RossDuquette/FYDP-Elec-Design/slave_board.brd

## EAGLE design slave_board.brd (2019-01-23)

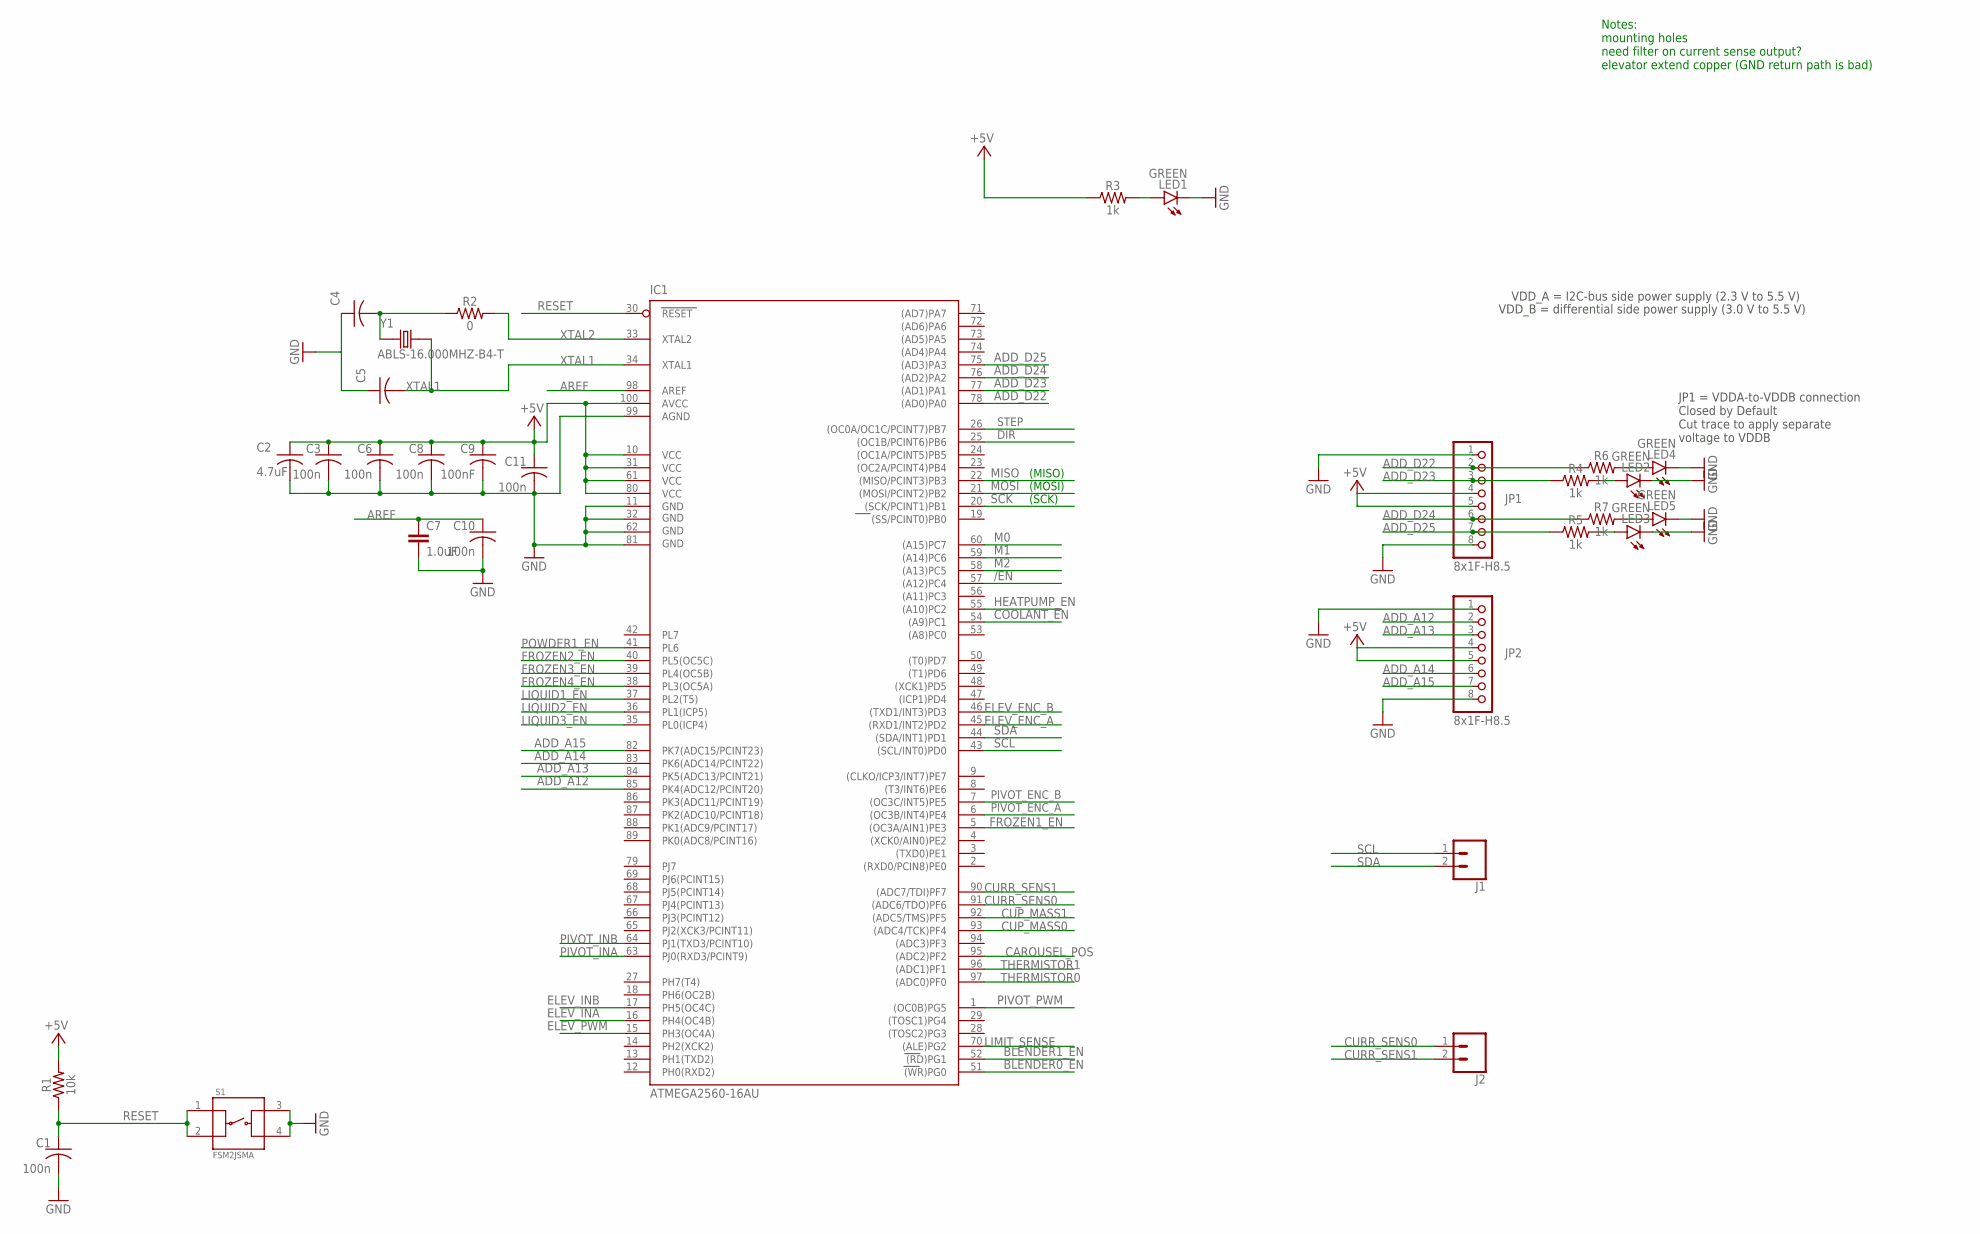
[picture p7: schematic slave_board.sch, sheet 1, Main]

Parts:
C1, C3, C6, C8, C10, C11: 100n; C0603
C2: 4.7uF; C0603
C4, C5: 15pF; C0603
C7: 1.0uF; 0603
C9: 100nF; C0603
IC1: ATMEGA2560-16AU; TQFP100
J1, J2: CONN_02; 1X02
JP1, JP2: 8x1F-H8.5; 1X08
LED1, LED2, LED3, LED4, LED5: GREEN; CHIP-LED0805
R1: 10k; 0603
R2: 0; 0603
R3, R4, R5, R6, R7: 1k; 0603
S1: FSM2JSMA
Y1: ABLS-16.000MHZ-B4-T

Connections:
+5V: C2.1, C3.1, C6.1, C8.1, C9.1, C11.1, IC1.10 (VCC), IC1.31 (VCC1), IC1.61 (VCC2), IC1.80 (VCC3), IC1.100 (AVCC), JP1.4, JP1.5, JP2.4, JP2.5, R1.2, R3.1; also elsewhere on the board
/EN: IC1.57 ((A12)PC4); also elsewhere on the board
ADD_A12: IC1.85 (PK4(ADC12/PCINT20)), JP2.2
ADD_A13: IC1.84 (PK5(ADC13/PCINT21)), JP2.3
ADD_A14: IC1.83 (PK6(ADC14/PCINT22)), JP2.6
ADD_A15: IC1.82 (PK7(ADC15/PCINT23)), JP2.7
ADD_D22: IC1.78 ((AD0)PA0), JP1.2, R6.1
ADD_D23: IC1.77 ((AD1)PA1), JP1.3, R4.1
ADD_D24: IC1.76 ((AD2)PA2), JP1.6, R7.1
ADD_D25: IC1.75 ((AD3)PA3), JP1.7, R5.1
AREF: C7.1, C10.1, IC1.98 (AREF)
BLENDER0_EN: IC1.51 ((WR)PG0); also elsewhere on the board
BLENDER1_EN: IC1.52 ((RD)PG1); also elsewhere on the board
CAROUSEL_POS: IC1.95 ((ADC2)PF2); also elsewhere on the board
COOLANT_EN: IC1.54 ((A9)PC1); also elsewhere on the board
CUP_MASS0: IC1.93 ((ADC4/TCK)PF4); also elsewhere on the board
CUP_MASS1: IC1.92 ((ADC5/TMS)PF5); also elsewhere on the board
CURR_SENS0: IC1.91 ((ADC6/TDO)PF6), J2.1; also elsewhere on the board
CURR_SENS1: IC1.90 ((ADC7/TDI)PF7), J2.2; also elsewhere on the board
DIR: IC1.25 ((OC1B/PCINT6)PB6); also elsewhere on the board
ELEV_ENC_A: IC1.45 ((RXD1/INT2)PD2); also elsewhere on the board
ELEV_ENC_B: IC1.46 ((TXD1/INT3)PD3); also elsewhere on the board
ELEV_INA: IC1.16 (PH4(OC4B)); also elsewhere on the board
ELEV_INB: IC1.17 (PH5(OC4C)); also elsewhere on the board
ELEV_PWM: IC1.15 (PH3(OC4A)); also elsewhere on the board
FROZEN1_EN: IC1.5 ((OC3A/AIN1)PE3); also elsewhere on the board
FROZEN2_EN: IC1.40 (PL5(OC5C)); also elsewhere on the board
FROZEN3_EN: IC1.39 (PL4(OC5B)); also elsewhere on the board
FROZEN4_EN: IC1.38 (PL3(OC5A)); also elsewhere on the board
GND: C1.2, C2.2, C3.2, C4.1, C5.1, C6.2, C7.2, C8.2, C9.2, C10.2, C11.2, IC1.11 (GND), IC1.32 (GND1), IC1.62 (GND2), IC1.81 (GND3), IC1.99 (AGND), JP1.1, JP1.8, JP2.1, JP2.8, LED1.C, LED2.C, LED3.C, LED4.C, LED5.C, S1.3, S1.4; also elsewhere on the board
HEATPUMP_EN: IC1.55 ((A10)PC2); also elsewhere on the board
LIMIT_SENSE: IC1.70 ((ALE)PG2); also elsewhere on the board
LIQUID1_EN: IC1.37 (PL2(T5)); also elsewhere on the board
LIQUID2_EN: IC1.36 (PL1(ICP5)); also elsewhere on the board
LIQUID3_EN: IC1.35 (PL0(ICP4)); also elsewhere on the board
M0: IC1.60 ((A15)PC7); also elsewhere on the board
M1: IC1.59 ((A14)PC6); also elsewhere on the board
M2: IC1.58 ((A13)PC5); also elsewhere on the board
MISO: IC1.22 ((MISO/PCINT3)PB3); also elsewhere on the board
MOSI: IC1.21 ((MOSI/PCINT2)PB2); also elsewhere on the board
unnamed: LED5.A, R7.2
unnamed: LED1.A, R3.2
unnamed: LED3.A, R5.2
unnamed: LED4.A, R6.2
unnamed: LED2.A, R4.2
unnamed: C4.2, R2.1, Y1.1
PIVOT_ENC_A: IC1.6 ((OC3B/INT4)PE4); also elsewhere on the board
PIVOT_ENC_B: IC1.7 ((OC3C/INT5)PE5); also elsewhere on the board
PIVOT_INA: IC1.63 (PJ0(RXD3/PCINT9)); also elsewhere on the board
PIVOT_INB: IC1.64 (PJ1(TXD3/PCINT10)); also elsewhere on the board
PIVOT_PWM: IC1.1 ((OC0B)PG5); also elsewhere on the board
POWDER1_EN: IC1.41 (PL6); also elsewhere on the board
RESET: C1.1, IC1.30 (RESET), R1.1, S1.1, S1.2; also elsewhere on the board
SCK: IC1.20 ((SCK/PCINT1)PB1); also elsewhere on the board
SCL: IC1.43 ((SCL/INT0)PD0), J1.1; also elsewhere on the board
SDA: IC1.44 ((SDA/INT1)PD1), J1.2; also elsewhere on the board
STEP: IC1.26 ((OC0A/OC1C/PCINT7)PB7); also elsewhere on the board
THERMISTOR0: IC1.97 ((ADC0)PF0); also elsewhere on the board
THERMISTOR1: IC1.96 ((ADC1)PF1); also elsewhere on the board
XTAL1: C5.2, IC1.34 (XTAL1), Y1.2
XTAL2: IC1.33 (XTAL2), R2.2

Notes on the sheet:
Notes: mounting holes need filter on current sense output? elevator extend copper (GND return path is bad)
JP1 = VDDA-to-VDDB connection Closed by Default Cut trace to apply separate voltage to VDDB
VDD_A = I2C-bus side power supply (2.3 V to 5.5 V)
VDD_B = differential side power supply (3.0 V to 5.5 V)
(MISO)
(SCK)
(MOSI)

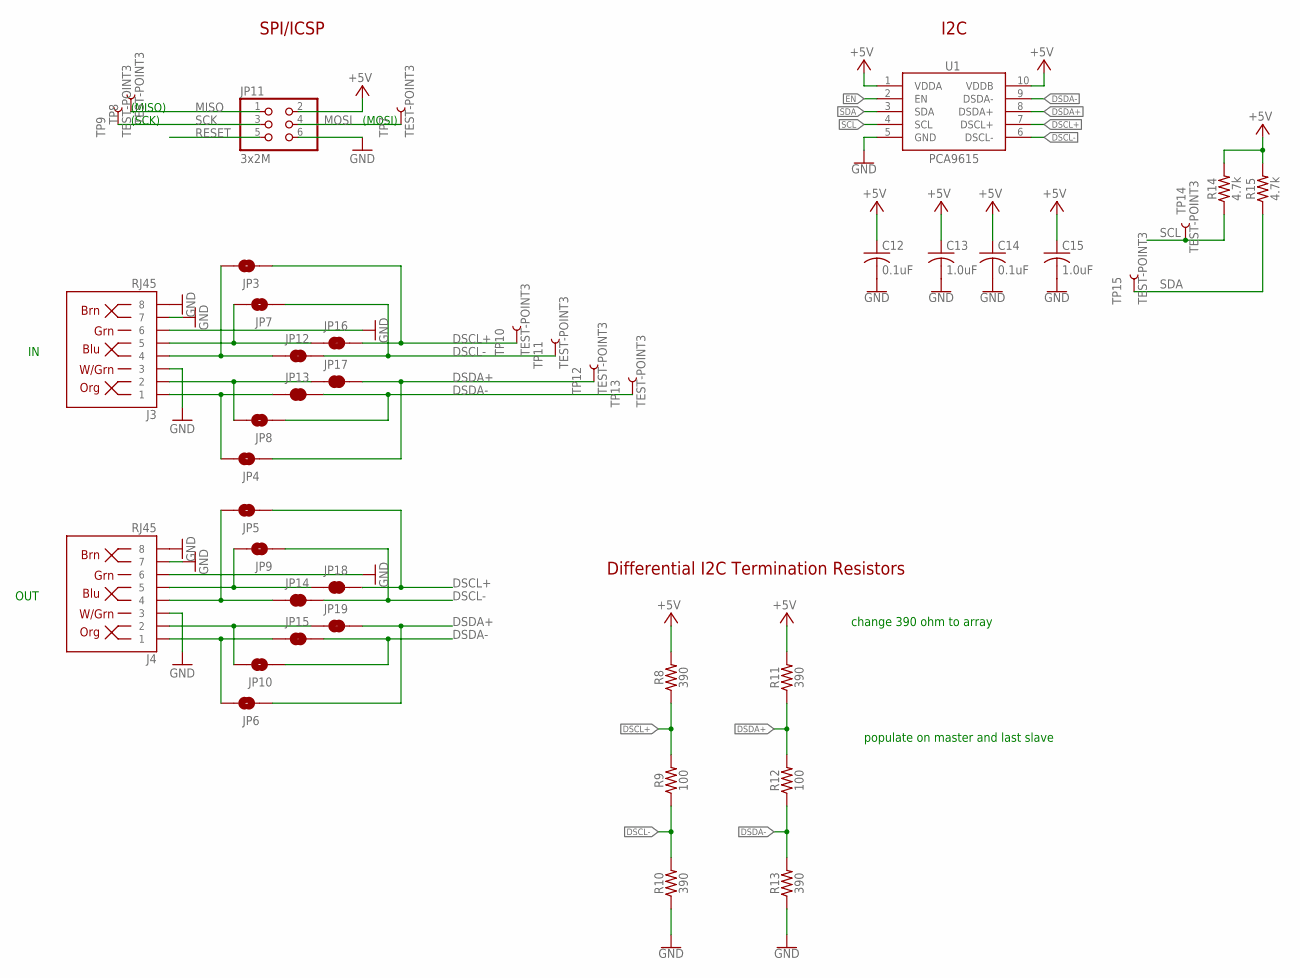
[picture p8: schematic slave_board.sch, sheet 2, COMMS]

Parts:
C12, C14: 0.1uF; C0603
C13, C15: 1.0uF; C0603
J3, J4: RJ45; RJ45-8
JP3, JP4, JP5, JP6, JP7, JP8, JP9, JP10: JUMPER-SMT_2_NO_NO-SILK; SMT-JUMPER_2_NO_NO-SILK
JP11: 3x2M; 2X03
JP12, JP13, JP14, JP15, JP16, JP17, JP18, JP19: JUMPER-SMT_2_NC_TRACE_NO-SILK; SMT-JUMPER_2_NC_TRACE_NO-SILK
R8, R10, R11, R13: 390; 0603
R9, R12: 100; 0603
R14, R15: 4.7k; 0603
TP7, TP8, TP9, TP10, TP11, TP12, TP13, TP14, TP15: TEST-POINT3; PAD.03X.03
U1: PCA9615; SPARKFUN-IC-COMMS_TSSOP10

Connections:
+5V: C12.1, C13.1, C14.1, C15.1, JP11.2, R8.2, R11.2, R14.2, R15.2, U1.1 (VDDA), U1.10 (VDDB); also elsewhere on the board
DSCL+: J3.5, J4.5, JP3.1, JP5.1, JP7.2, JP9.2, JP16.1, JP16.2, JP18.1, JP18.2, R8.1, R9.2, TP10.P$1, U1.7 (DSCL+)
DSCL-: J3.4, J4.4, JP3.2, JP5.2, JP7.1, JP9.1, JP12.1, JP12.2, JP14.1, JP14.2, R9.1, R10.2, TP11.P$1, U1.6 (DSCL-)
DSDA+: J3.2, J4.2, JP4.1, JP6.1, JP8.2, JP10.2, JP17.1, JP17.2, JP19.1, JP19.2, R11.1, R12.2, TP12.P$1, U1.8 (DSDA+)
DSDA-: J3.1, J4.1, JP4.2, JP6.2, JP8.1, JP10.1, JP13.1, JP13.2, JP15.1, JP15.2, R12.1, R13.2, TP13.P$1, U1.9 (DSDA-)
EN: U1.2 (EN)
GND: C12.2, C13.2, C14.2, C15.2, J3.3, J3.6, J3.7, J3.8, J4.3, J4.6, J4.7, J4.8, JP11.6, R10.1, R13.1, U1.5 (GND); also elsewhere on the board
MISO: JP11.1, TP8.P$1; also elsewhere on the board
MOSI: JP11.4, TP7.P$1; also elsewhere on the board
RESET: JP11.5; also elsewhere on the board
SCK: JP11.3, TP9.P$1; also elsewhere on the board
SCL: R14.1, TP14.P$1, U1.4 (SCL); also elsewhere on the board
SDA: R15.1, TP15.P$1, U1.3 (SDA); also elsewhere on the board

Notes on the sheet:
(SCK)
(MISO)
(MOSI)
I2C
SPI/ICSP
Differential I2C Termination Resistors
OUT
populate on master and last slave
change 390 ohm to array

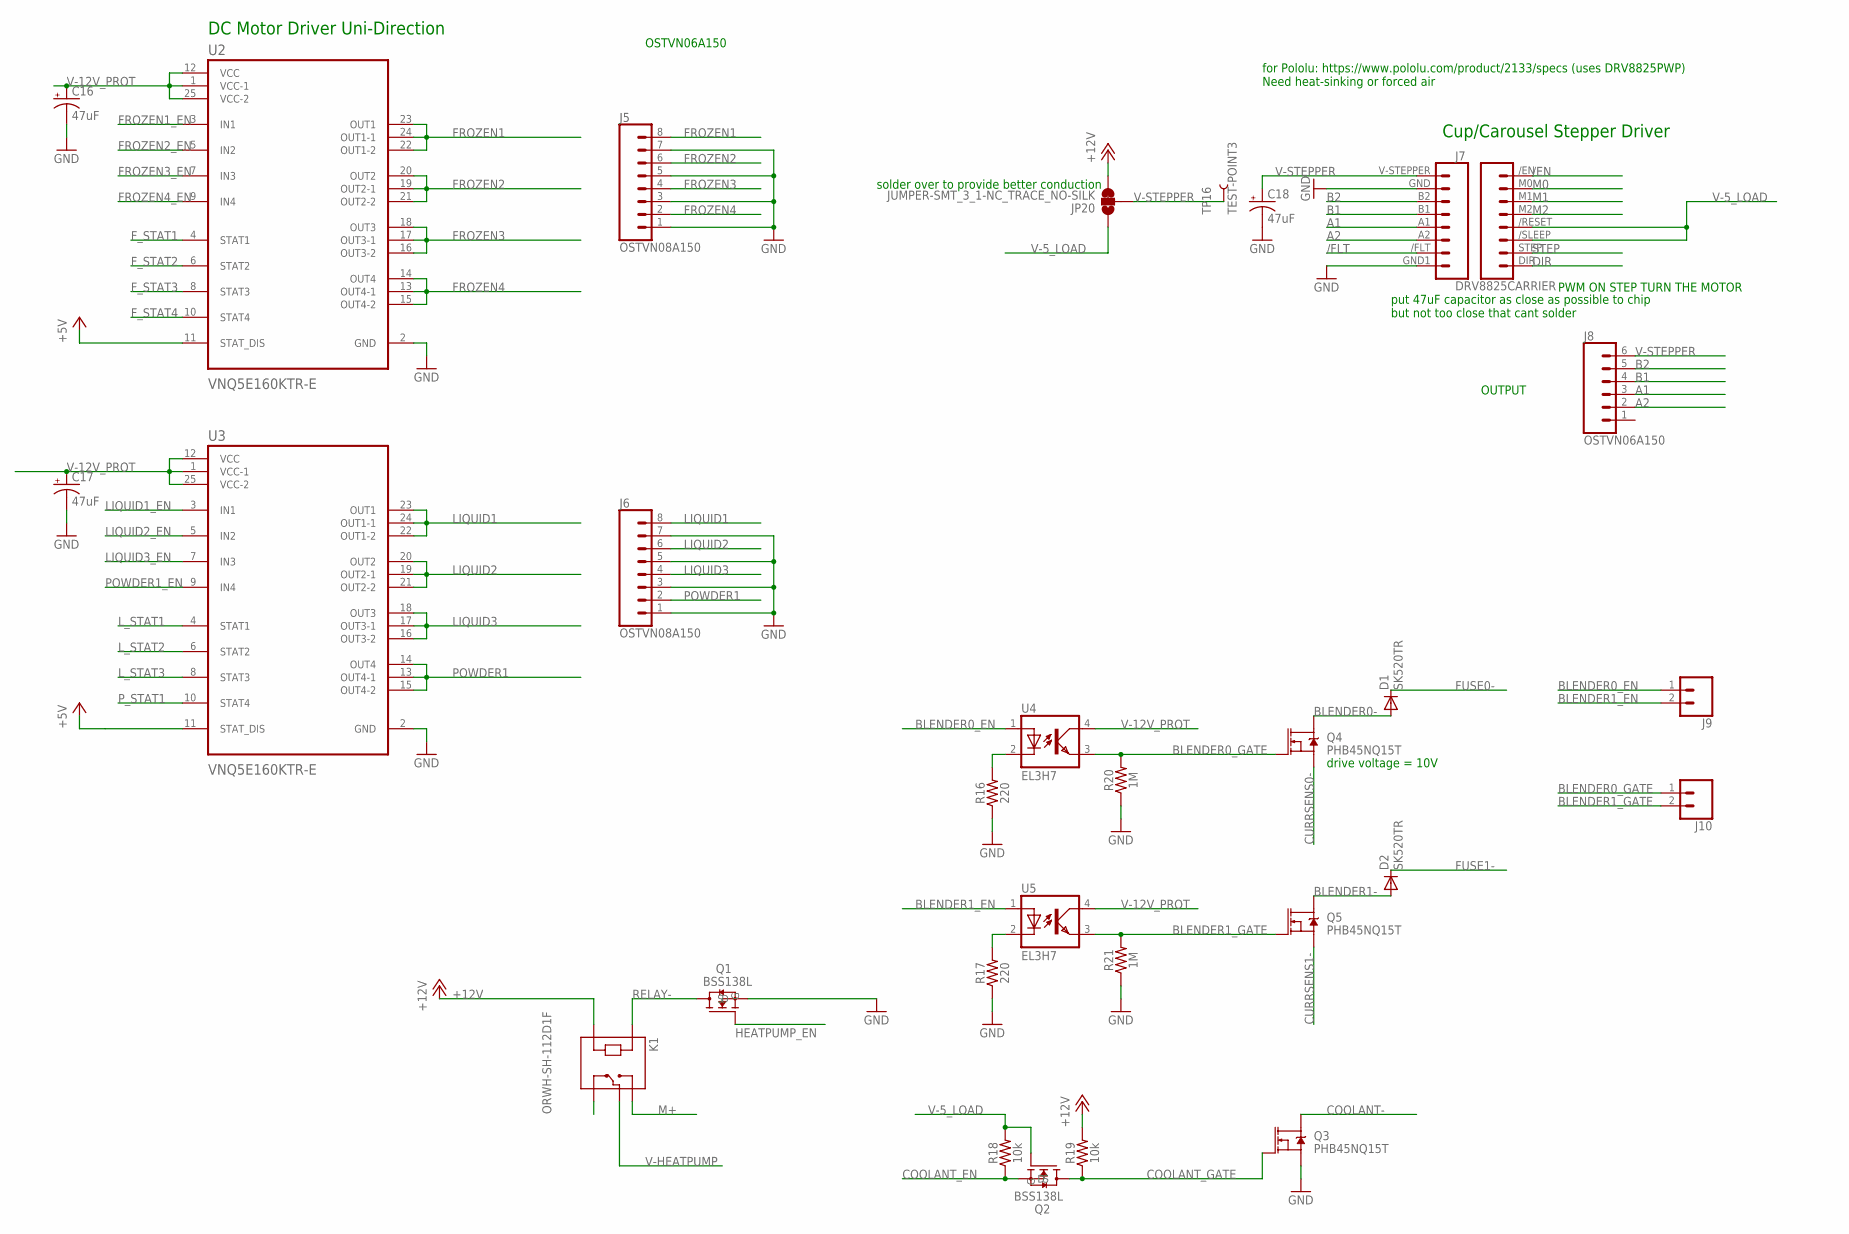
[picture p9: schematic slave_board.sch, sheet 3, Motors1]

Parts:
C16, C17, C18: 47uF; PANASONIC_D
D1, D2: SK520TR
J5, J6: OSTVN08A150; 8PIN_SCREW_TERMINAL
J7: DRV8825CARRIER
J8: OSTVN06A150; 6PIN_SCREW_TERMINAL
J9, J10: CONN_02; 1X02
JP20: JUMPER-SMT_3_1-NC_TRACE_NO-SILK; SMT-JUMPER_3_1-NC_TRACE_NO-SILK
K1: ORWH-SH-112D1F
Q1, Q2: BSS138L
Q3, Q4, Q5: PHB45NQ15T
R16, R17: 220; 0603
R18, R19: 10k; 0603
R20, R21: 1M; 0603
TP16: TEST-POINT3; PAD.03X.03
U2, U3: VNQ5E160KTR-E; SOP80P1030X245-25N
U4, U5: EL3H7

Connections:
+5V: U2.11 (STAT_DIS), U3.11 (STAT_DIS); also elsewhere on the board
+12V: JP20.3, K1.A2, R19.2; also elsewhere on the board
/EN: J7./EN (16); also elsewhere on the board
/FLT: J7./FLT (7)
A1: J7.A1 (5), J8.3
A2: J7.A2 (6), J8.2
B1: J7.B1 (4), J8.4
B2: J7.B2 (3), J8.5
BLENDER0-: D1.1 (A), Q4.2 (D); also elsewhere on the board
BLENDER0_EN: J9.1, U4.1; also elsewhere on the board
BLENDER0_GATE: J10.1, Q4.1 (G), R20.2, U4.3
BLENDER1-: D2.1 (A), Q5.2 (D); also elsewhere on the board
BLENDER1_EN: J9.2, U5.1; also elsewhere on the board
BLENDER1_GATE: J10.2, Q5.1 (G), R21.2, U5.3
COOLANT-: Q3.2 (D); also elsewhere on the board
COOLANT_EN: Q2.S, R18.1; also elsewhere on the board
COOLANT_GATE: Q2.D, Q3.1 (G), R19.1
CURRSENS0-: Q4.3 (S); also elsewhere on the board
CURRSENS1-: Q5.3 (S); also elsewhere on the board
DIR: J7.DIR (9); also elsewhere on the board
FROZEN1: J5.8, U2.22 (OUT1-2), U2.23 (OUT1), U2.24 (OUT1-1)
FROZEN1_EN: U2.3 (IN1); also elsewhere on the board
FROZEN2: J5.6, U2.19 (OUT2-1), U2.20 (OUT2), U2.21 (OUT2-2)
FROZEN2_EN: U2.5 (IN2); also elsewhere on the board
FROZEN3: J5.4, U2.16 (OUT3-2), U2.17 (OUT3-1), U2.18 (OUT3)
FROZEN3_EN: U2.7 (IN3); also elsewhere on the board
FROZEN4: J5.2, U2.13 (OUT4-1), U2.14 (OUT4), U2.15 (OUT4-2)
FROZEN4_EN: U2.9 (IN4); also elsewhere on the board
FUSE0-: D1.2 (C); also elsewhere on the board
FUSE1-: D2.2 (C); also elsewhere on the board
F_STAT1: U2.4 (STAT1)
F_STAT2: U2.6 (STAT2)
F_STAT3: U2.8 (STAT3)
F_STAT4: U2.10 (STAT4)
GND: C16.-, C17.-, C18.-, J5.1, J5.3, J5.5, J5.7, J6.1, J6.3, J6.5, J6.7, J7.GND (2), J7.GND1 (8), Q1.S, Q3.3 (S), R16.1, R17.1, R20.1, R21.1, U2.2 (GND), U3.2 (GND); also elsewhere on the board
HEATPUMP_EN: Q1.G; also elsewhere on the board
LIQUID1: J6.8, U3.22 (OUT1-2), U3.23 (OUT1), U3.24 (OUT1-1)
LIQUID1_EN: U3.3 (IN1); also elsewhere on the board
LIQUID2: J6.6, U3.19 (OUT2-1), U3.20 (OUT2), U3.21 (OUT2-2)
LIQUID2_EN: U3.5 (IN2); also elsewhere on the board
LIQUID3: J6.4, U3.16 (OUT3-2), U3.17 (OUT3-1), U3.18 (OUT3)
LIQUID3_EN: U3.7 (IN3); also elsewhere on the board
L_STAT1: U3.4 (STAT1)
L_STAT2: U3.6 (STAT2)
L_STAT3: U3.8 (STAT3)
M0: J7.M0 (15); also elsewhere on the board
M1: J7.M1 (14); also elsewhere on the board
M2: J7.M2 (13); also elsewhere on the board
M+: K1.NO; also elsewhere on the board
unnamed: R17.2, U5.2
unnamed: R16.2, U4.2
POWDER1: J6.2, U3.13 (OUT4-1), U3.14 (OUT4), U3.15 (OUT4-2)
POWDER1_EN: U3.9 (IN4); also elsewhere on the board
P_STAT1: U3.10 (STAT4)
RELAY-: K1.A1, Q1.D
STEP: J7.STEP (10); also elsewhere on the board
V-5_LOAD: J7./RESET (12), J7./SLEEP (11), JP20.1, Q2.G, R18.2; also elsewhere on the board
V-12V_PROT: C16.+, C17.+, U2.1 (VCC-1), U2.12 (VCC), U2.25 (VCC-2), U3.1 (VCC-1), U3.12 (VCC), U3.25 (VCC-2), U4.4, U5.4; also elsewhere on the board
V-HEATPUMP: K1.COM; also elsewhere on the board
V-STEPPER: C18.+, J7.V-STEPPER (1), J8.6, JP20.2, TP16.P$1

Notes on the sheet:
DC Motor Driver Uni-Direction
Cup/Carousel Stepper Driver
for Pololu: https://www.pololu.com/product/2133/specs (uses DRV8825PWP) Need heat-sinking or forced air
put 47uF capacitor as close as possible to chip but not too close that cant solder
OUTPUT
PWM ON STEP TURN THE MOTOR
solder over to provide better conduction
drive voltage = 10V
OSTVN06A150

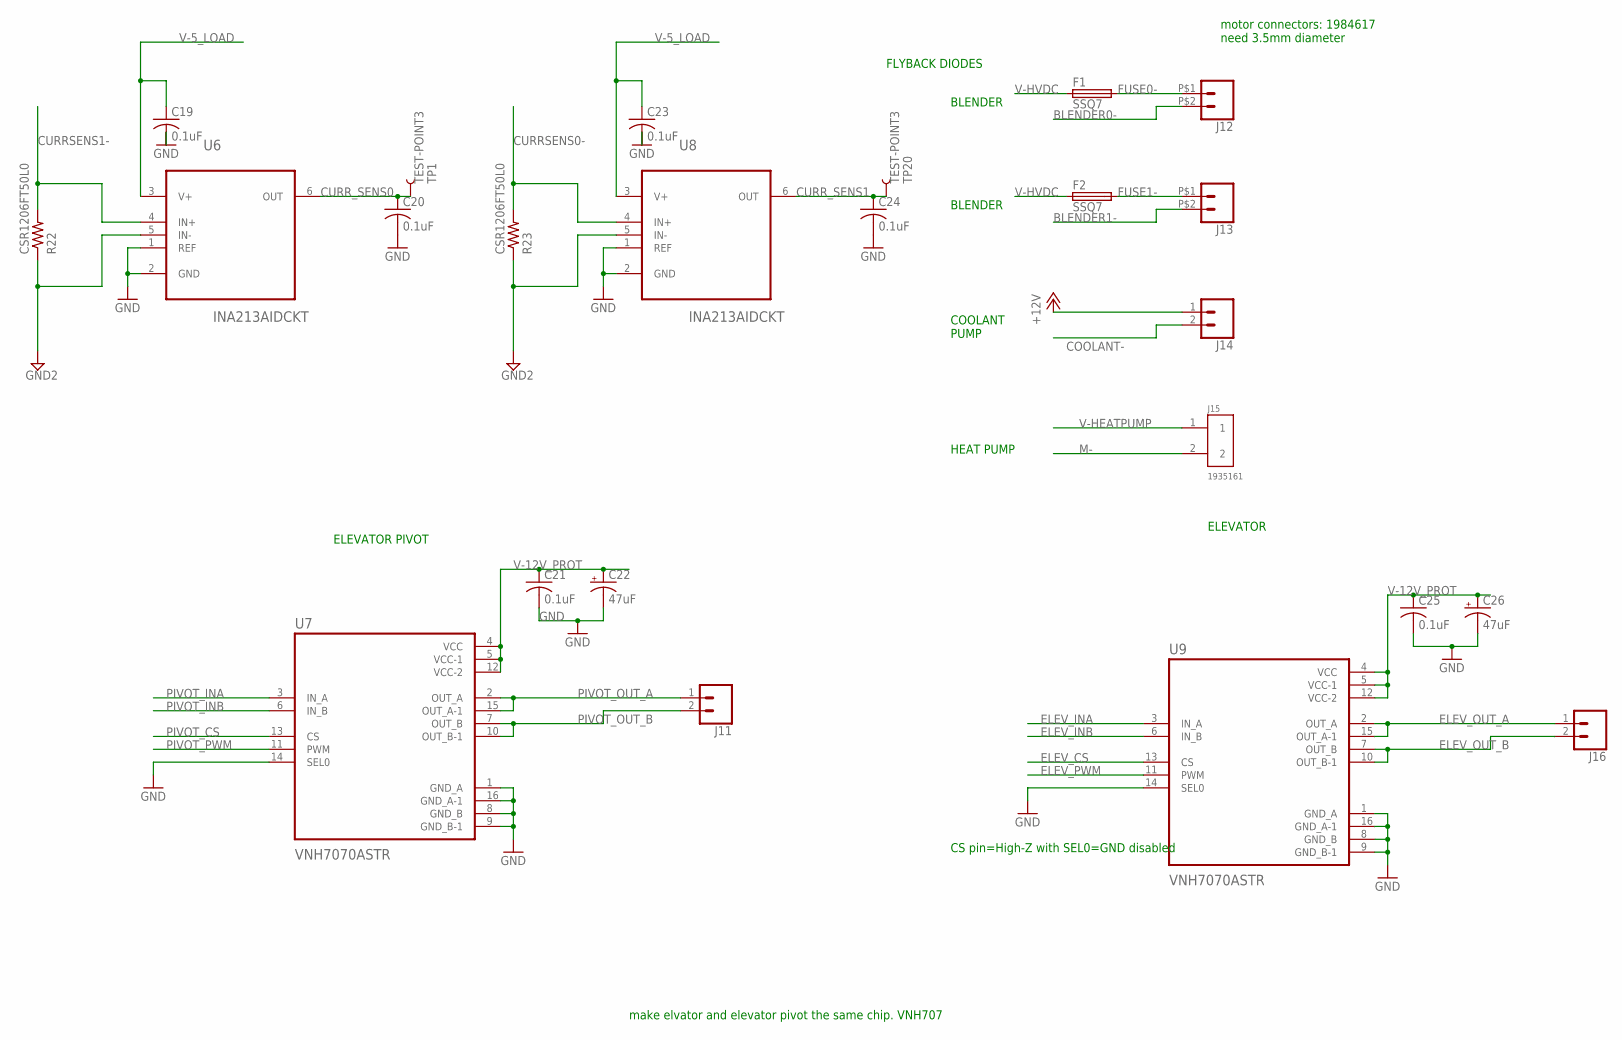
[picture p10: schematic slave_board.sch, sheet 4, Motors2]

Parts:
C19, C20, C21, C23, C24, C25: 0.1uF; C0603
C22, C26: 47uF; PANASONIC_D
F1, F2: SSQ7
J11, J14, J16: CONN_02; 1X02
J12, J13: CONN_02PTH2; 1X02_BIG
J15: 1935161; PHOENIX_1935161
R22, R23: CSR1206FT50L0
TP1, TP20: TEST-POINT3; PAD.03X.03
U6, U8: INA213AIDCKT; SOT65P210X110-6N
U7, U9: VNH7070ASTR

Connections:
+12V: J14.1; also elsewhere on the board
BLENDER0-: J12.P$2 (2); also elsewhere on the board
BLENDER1-: J13.P$2 (2); also elsewhere on the board
COOLANT-: J14.2; also elsewhere on the board
CURRSENS0-: R23.2, U8.4 (IN+); also elsewhere on the board
CURRSENS1-: R22.2, U6.4 (IN+); also elsewhere on the board
CURR_SENS0: C20.1, TP1.P$1, U6.6 (OUT); also elsewhere on the board
CURR_SENS1: C24.1, TP20.P$1, U8.6 (OUT); also elsewhere on the board
ELEV_CS: U9.13 (CS)
ELEV_INA: U9.3 (IN_A); also elsewhere on the board
ELEV_INB: U9.6 (IN_B); also elsewhere on the board
ELEV_OUT_A: J16.1, U9.2 (OUT_A), U9.15 (OUT_A-1)
ELEV_OUT_B: J16.2, U9.7 (OUT_B), U9.10 (OUT_B-1)
ELEV_PWM: U9.11 (PWM); also elsewhere on the board
FUSE0-: F1.2, J12.P$1 (1); also elsewhere on the board
FUSE1-: F2.2, J13.P$1 (1); also elsewhere on the board
GND: C19.2, C20.2, C21.2, C22.-, C23.2, C24.2, C25.2, C26.-, U6.1 (REF), U6.2 (GND), U7.1 (GND_A), U7.8 (GND_B), U7.9 (GND_B-1), U7.14 (SEL0), U7.16 (GND_A-1), U8.1 (REF), U8.2 (GND), U9.1 (GND_A), U9.8 (GND_B), U9.9 (GND_B-1), U9.14 (SEL0), U9.16 (GND_A-1); also elsewhere on the board
GND2: R22.1, R23.1, U6.5 (IN-), U8.5 (IN-); also elsewhere on the board
M-: J15.2; also elsewhere on the board
PIVOT_CS: U7.13 (CS)
PIVOT_INA: U7.3 (IN_A); also elsewhere on the board
PIVOT_INB: U7.6 (IN_B); also elsewhere on the board
PIVOT_OUT_A: J11.1, U7.2 (OUT_A), U7.15 (OUT_A-1)
PIVOT_OUT_B: J11.2, U7.7 (OUT_B), U7.10 (OUT_B-1)
PIVOT_PWM: U7.11 (PWM); also elsewhere on the board
V-5_LOAD: C19.1, C23.1, U6.3 (V+), U8.3 (V+); also elsewhere on the board
V-12V_PROT: C21.1, C22.+, C25.1, C26.+, U7.4 (VCC), U7.5 (VCC-1), U7.12 (VCC-2), U9.4 (VCC), U9.5 (VCC-1), U9.12 (VCC-2); also elsewhere on the board
V-HEATPUMP: J15.1; also elsewhere on the board
V-HVDC: F1.1, F2.1; also elsewhere on the board

Notes on the sheet:
ELEVATOR PIVOT
ELEVATOR
CS pin=High-Z with SEL0=GND disabled
make elvator and elevator pivot the same chip. VNH707
FLYBACK DIODES
BLENDER
HEAT PUMP
COOLANT PUMP
motor connectors: 1984617 need 3.5mm diameter

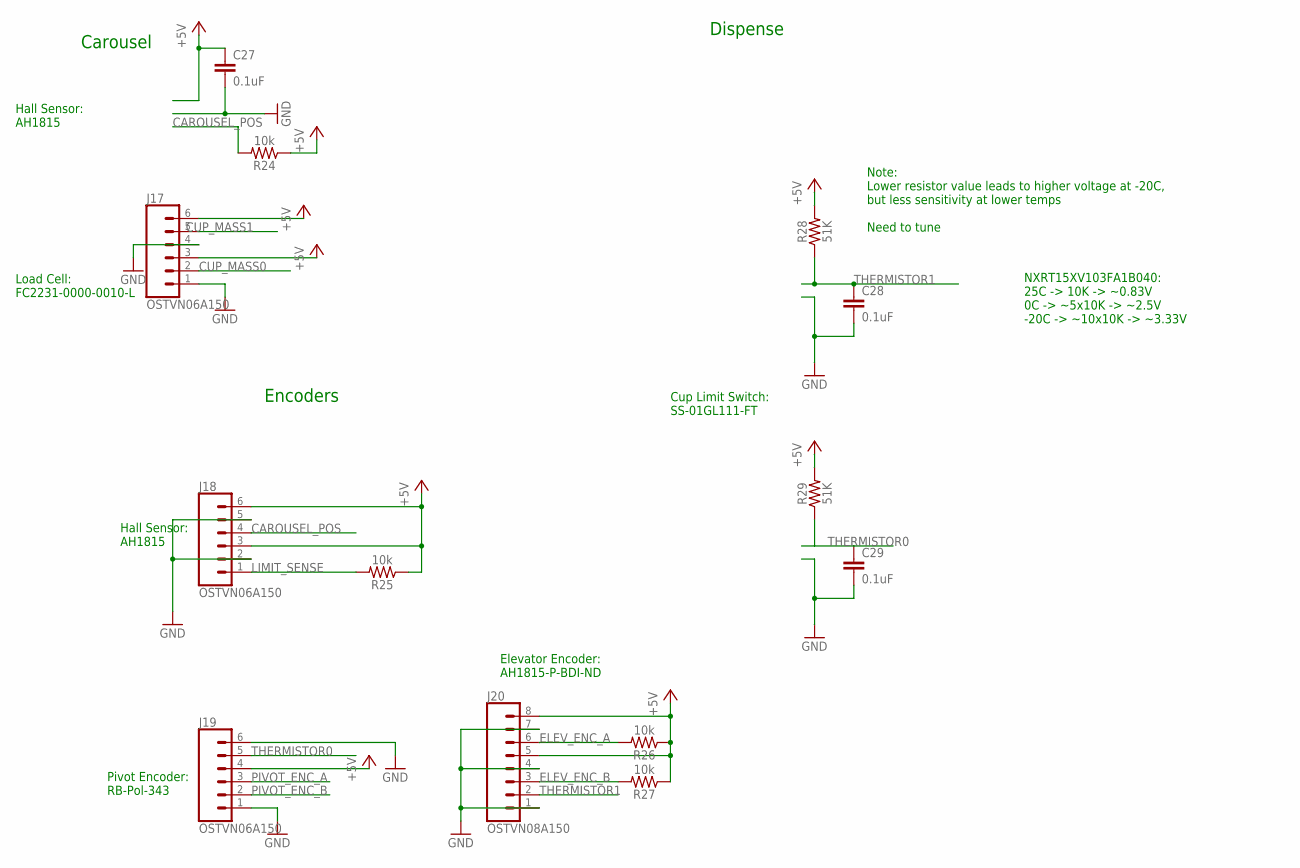
[picture p11: schematic slave_board.sch, sheet 5, Sensors]

Parts:
C27, C28, C29: 0.1uF; 0603
J17, J18, J19: OSTVN06A150; 6PIN_SCREW_TERMINAL
J20: OSTVN08A150; 8PIN_SCREW_TERMINAL
R24, R25, R26, R27: 10k; 0603
R28, R29: 51K; 0603

Connections:
+5V: C27.1, J17.3, J17.6, J18.3, J18.6, J19.4, J20.5, J20.8, R24.1, R25.1, R26.1, R27.1, R28.2, R29.2; also elsewhere on the board
CAROUSEL_POS: J18.4, R24.2; also elsewhere on the board
CUP_MASS0: J17.2; also elsewhere on the board
CUP_MASS1: J17.5; also elsewhere on the board
ELEV_ENC_A: J20.6, R26.2; also elsewhere on the board
ELEV_ENC_B: J20.3, R27.2; also elsewhere on the board
GND: C27.2, C28.2, C29.2, J17.1, J17.4, J18.2, J18.5, J19.1, J19.6, J20.1, J20.4, J20.7; also elsewhere on the board
LIMIT_SENSE: J18.1, R25.2; also elsewhere on the board
PIVOT_ENC_A: J19.3; also elsewhere on the board
PIVOT_ENC_B: J19.2; also elsewhere on the board
THERMISTOR0: C29.1, J19.5, R29.1; also elsewhere on the board
THERMISTOR1: C28.1, J20.2, R28.1; also elsewhere on the board

Notes on the sheet:
Carousel
Dispense
Hall Sensor: AH1815
Load Cell: FC2231-0000-0010-L
Cup Limit Switch: SS-01GL111-FT
NXRT15XV103FA1B040: 25C -> 10K -> ~0.83V 0C -> ~5x10K -> ~2.5V -20C -> ~10x10K -> ~3.33V
Note: Lower resistor value leads to higher voltage at -20C, but less sensitivity at lower temps Need to tune
Encoders
Pivot Encoder: RB-Pol-343
Elevator Encoder: AH1815-P-BDI-ND

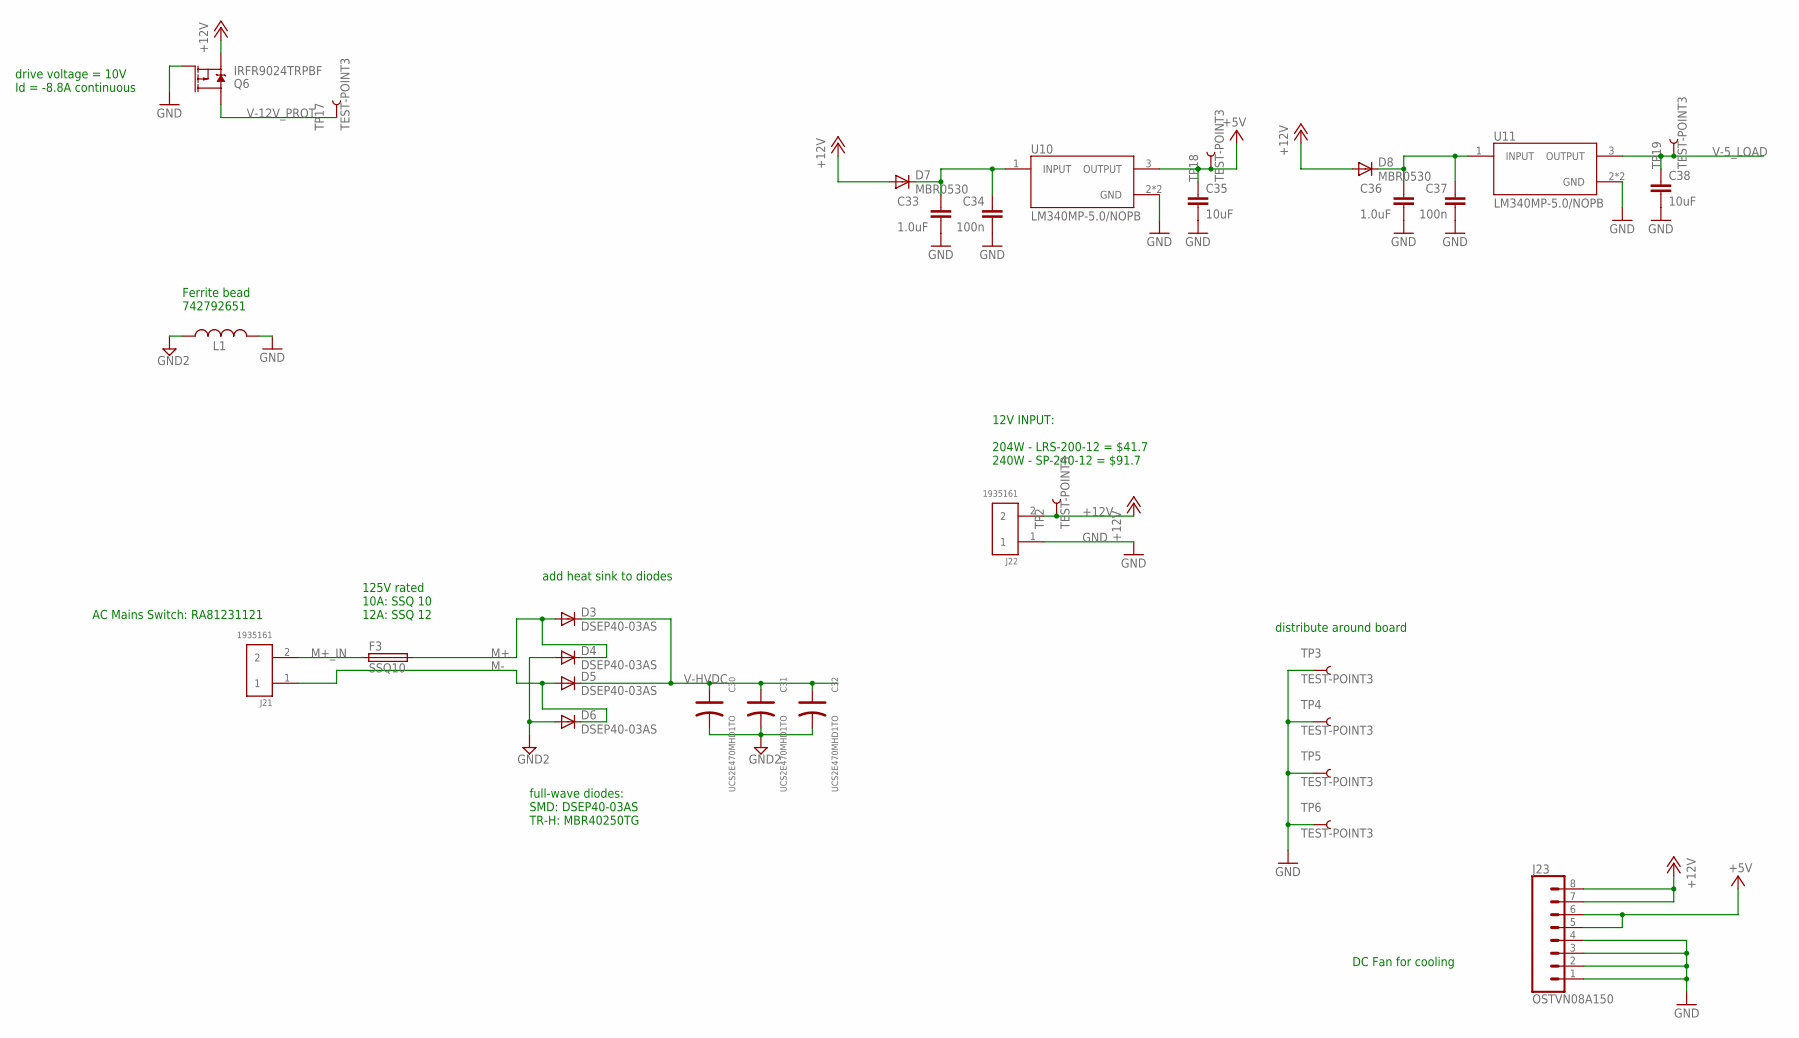
[picture p12: schematic slave_board.sch, sheet 6, Power]

Parts:
C30, C31, C32: UCS2E470MHD1TO
C33, C36: 1.0uF; 0603
C34, C37: 100n; C0603-ROUND
C35, C38: 10uF; 0805
D3, D4, D5, D6: DSEP40-03AS
D7, D8: MBR0530
F3: SSQ10
J21, J22: 1935161; PHOENIX_1935161
J23: OSTVN08A150; 8PIN_SCREW_TERMINAL
L1: 742792651
Q6: IRFR9024TRPBF
TP2, TP3, TP4, TP5, TP6, TP17, TP18, TP19: TEST-POINT3; PAD.03X.03
U10, U11: LM340MP-5.0/NOPB; SOT230P700X180-4N

Connections:
+5V: C35.1, J23.5, J23.6, TP18.P$1, U10.3 (OUTPUT); also elsewhere on the board
+12V: D7.1 (A), D8.1 (A), J22.2, J23.7, J23.8, Q6.S, TP2.P$1; also elsewhere on the board
GND: C33.2, C34.2, C35.2, C36.2, C37.2, C38.2, J22.1, J23.1, J23.2, J23.3, J23.4, L1.P$2 (2), Q6.G, TP3.P$1, TP4.P$1, TP5.P$1, TP6.P$1, U10.2 (GND), U10.4 (GND), U11.2 (GND), U11.4 (GND); also elsewhere on the board
GND2: C30.-, C31.-, C32.-, D4.1 (A), D4.3 (A), D6.1 (A), D6.3 (A), L1.P$1 (1); also elsewhere on the board
M+: D3.1 (A), D3.3 (A), D4.4 (C), F3.2; also elsewhere on the board
M+_IN: F3.1, J21.2
M-: D5.1 (A), D5.3 (A), D6.4 (C), J21.1; also elsewhere on the board
unnamed: C33.1, C34.1, D7.2 (C), U10.1 (INPUT)
unnamed: C36.1, C37.1, D8.2 (C), U11.1 (INPUT)
V-5_LOAD: C38.1, TP19.P$1, U11.3 (OUTPUT); also elsewhere on the board
V-12V_PROT: Q6.D, TP17.P$1; also elsewhere on the board
V-HVDC: C30.+, C31.+, C32.+, D3.4 (C), D5.4 (C); also elsewhere on the board

Notes on the sheet:
full-wave diodes: SMD: DSEP40-03AS TR-H: MBR40250TG
125V rated 10A: SSQ 10 12A: SSQ 12
12V INPUT: 204W - LRS-200-12 = $41.7 240W - SP-240-12 = $91.7
add heat sink to diodes
AC Mains Switch: RA81231121
DC Fan for cooling
drive voltage = 10V Id = -8.8A continuous
distribute around board
Ferrite bead 742792651

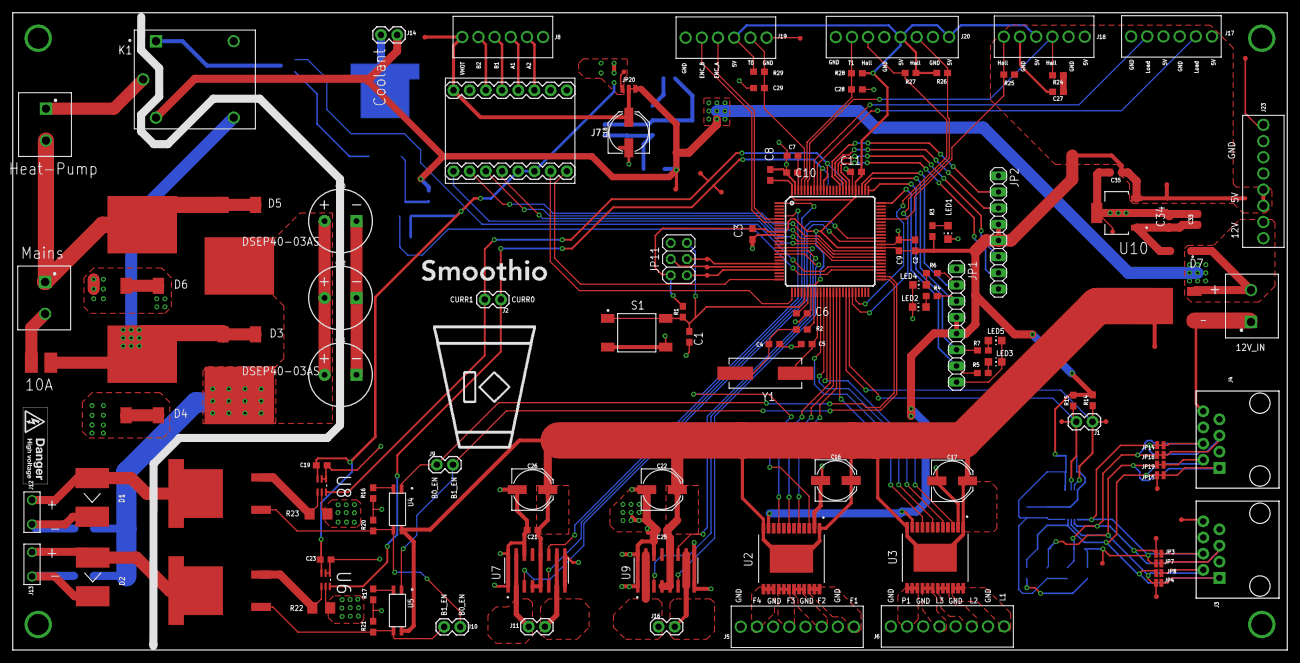
[picture p13: board slave_board.brd from above]

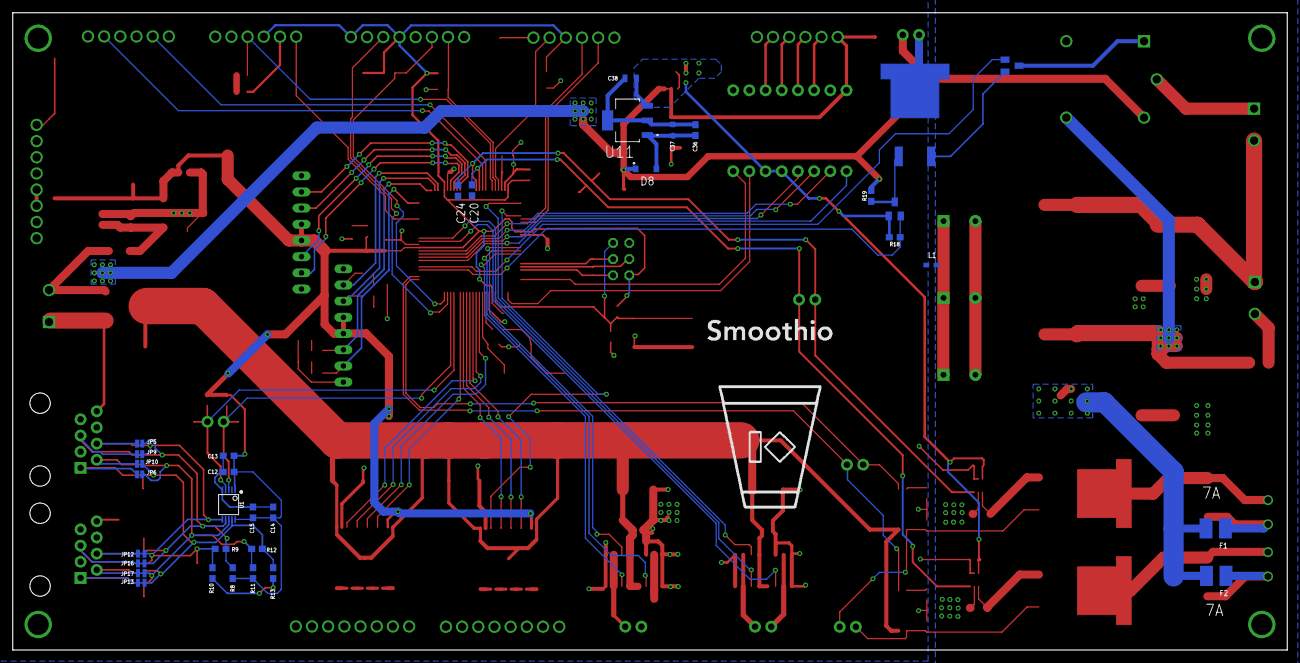
[picture p14: board slave_board.brd from below]

Board: 2 copper layers, 200.0 x 100.0 mm, 168 parts (34 on the bottom side), 106 nets.
