RossDuquette/FYDP-Elec-Design/(commit log)

2018-12-27 beginning of project
    [slave_board.brd, slave_board.sch]
2018-12-27 more work
    [slave_board.sch]
2018-12-28 selected motor and full-bridge parts - see comments in sheet
    [slave_board.sch]
2018-12-28 added some part selection - see comments in sheet
    [slave_board.sch]
2018-12-29 added some part selection
    [slave_board.brd, slave_board.sch]
2018-12-30 added some parts
    [slave_board.sch]
2018-12-30 full wave recitifer
    [slave_board.sch]
2019-01-01 fixed ref des'
2019-01-01 added elevator motors to schem
2019-01-03 schematic review changes
    [slave_board.sch]
2019-01-05 mains connector change
    [slave_board.sch]
2019-01-05 progress on component placement
    [slave_board.brd, slave_board.sch]
2019-01-07 rough part placement
    [slave_board.brd]
2019-01-07 board adjustments
    [slave_board.sch]
2019-01-08 fixed current sense
    [slave_board.brd, slave_board.sch]
2019-01-08 turned motor driver into new part
    [slave_board.brd, slave_board.sch]
2019-01-09 Reviewed with Danyon
    [slave_board.sch]
2019-01-09 Added encoders
    [slave_board.brd, slave_board.sch]
2019-01-09 merged changes and layout progress
    [slave_board.brd, slave_board.sch]
2019-01-09 Changed net names to align with names used for mcu
    [slave_board.brd, slave_board.sch]
2019-01-10 board progress - motors,i2c
    [slave_board.brd, slave_board.sch]
2019-01-10 board progress - motor routing
    [slave_board.brd, slave_board.sch]
2019-01-10 board progress - generic connections
    [slave_board.brd]
2019-01-10 board progress - new 5V, route comms
    [slave_board.brd, slave_board.sch]
2019-01-10 board progress - routing + new dispenser pin assignments
    [slave_board.brd, slave_board.sch]
2019-01-10 board progress - routing + ADC pin assignment
    [slave_board.brd, slave_board.sch]
2019-01-10 Routed mcu, except for additional pins
    [slave_board.brd, slave_board.sch]
2019-01-11 board progress - routing
    [slave_board.brd, slave_board.sch]
2019-01-11 board progress - power routing
    [slave_board.brd, slave_board.sch]
2019-01-11 board progress - routing additional digital plus analog
    [slave_board.brd]
2019-01-11 board progress
    [slave_board.brd]
2019-01-13 Fixed some errors
    [slave_board.brd, slave_board.sch]
2019-01-15 Resize board, add mounting holes
    [slave_board.brd, slave_board.sch]
2019-01-15 Added screw terminal headers
    [slave_board.brd, slave_board.sch]
2019-01-15 Placed another screw terminal
    [slave_board.brd, slave_board.sch]
2019-01-15 More screw terminals
    [slave_board.brd, slave_board.sch]
2019-01-16 Fixed silkscreen
    [slave_board.brd, slave_board.sch]
2019-01-16 Added mounting holes, logo
    [slave_board.brd]
2019-01-16 fixed air wires
    [slave_board.brd]
2019-01-17 Added HV warning. Moved current sense to after switch
    [slave_board.brd, slave_board.sch]
2019-01-17 Fixed all errors
    [slave_board.brd, slave_board.sch]
2019-01-17 current sense routing fix and high voltage keepout
    [slave_board.brd, slave_board.sch]
2019-01-17 flyback diode fix
    [slave_board.brd, slave_board.sch]
2019-01-18 added fuse amperage in silkscreen
    [slave_board.brd, slave_board.sch]
2019-01-20 increased blender vias to gnd, added individual blender fuses,addition aref cap, and debug leds
    [slave_board.brd, slave_board.sch]
2019-01-20 mapped additional elevator encoder input
    [slave_board.brd, slave_board.sch]
2019-01-20 Moved uc pins; fixed all DRCs
    [slave_board.brd, slave_board.sch]
2019-01-21 broke blender enable to terminal blocks
    [slave_board.brd, slave_board.sch]
2019-01-22 Morning changes from board review
    [slave_board.brd, slave_board.sch]
2019-01-22 Finished review changes
    [slave_board.brd, slave_board.sch]
2019-01-22 Few more changes
    [slave_board.brd, slave_board.sch]
2019-01-22 Renumbered components
    [slave_board.brd, slave_board.sch]
2019-01-22 Added labels to connectors
    [slave_board.brd, slave_board.sch]
2019-01-23 added gnd vias for mains
    [slave_board.brd, slave_board.sch]
2019-01-23 added gnd planes for high current parts
    [slave_board.brd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]
2019-01-27 Updated pdf of schematic
2019-02-14 Started wiring diagram
    [wiring_diagram.sch]
2019-02-15 Added fuses and switch
    [wiring_diagram.sch]
